AltusCilliers/Design-E-314/Design_E_314_ArcadeGame/Core/Src/main.c

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

/* Includes ------------------------------------------------------------------*/
#include "main.h"

ADC_HandleTypeDef hadc1;

I2C_HandleTypeDef hi2c1;

UART_HandleTypeDef huart2;

void SystemClock_Config(void);
static void MX_GPIO_Init(void);
static void MX_USART2_UART_Init(void);
static void MX_ADC1_Init(void);
static void MX_I2C1_Init(void);
/* USER CODE BEGIN 0 */

uint8_t i2cData[10];
uint8_t i2cMazeData[10];
int16_t ax;
int16_t ay;
int16_t az;
HAL_StatusTypeDef result;

volatile int8_t middle_pressed;
volatile int8_t left_pressed;
volatile int8_t up_pressed;
volatile int8_t down_pressed;
extern int8_t startgame;
int8_t chooseMaze=1;
int8_t startgame = -1;
int8_t xPrev;
int8_t yPrev;
int8_t corner_state=0;
int8_t tennisgameflag=0;
int8_t mazegameflag=0;
extern uint8_t mazemenuflag;
/* USER CODE END 0 */

/**
  * @brief  The application entry point.
  * @retval int
  */
int main(void)
{
  /* MCU Configuration--------------------------------------------------------*/

  /* Reset of all peripherals, Initializes the Flash interface and the Systick. */
  HAL_Init();

  /* Configure the system clock */
  SystemClock_Config();

  /* Initialize all configured peripherals */
  MX_GPIO_Init();
  MX_USART2_UART_Init();
  MX_ADC1_Init();
  MX_I2C1_Init();
  /* USER CODE BEGIN 2 */
	initialize_matrix();

	calibration_sequence();


	int8_t waitScreen=0;
	int8_t game_choose=0;

	game_choose = 3;


	i2cData[0]= 0x20;//set address to CTRL_REG_1
	i2cData[1]= 0x47; //setup REG 1
	//i2cData[1]= 0x57; //setup REG 1
	HAL_I2C_Master_Transmit(&hi2c1, 0x32, i2cData, 2, 10); //transmit

	i2cData[0]= 0x23;//set address to CTRL_REG_4
	i2cData[1]= 0x0;//setup REG 4
	HAL_I2C_Master_Transmit(&hi2c1, 0x32, i2cData, 2, 10);//transmit
//result=HAL_I2C_Master_Transmit(&hi2c1, 0x32, i2cData, 4, 10);


  /* USER CODE END 2 */

  /* Infinite loop */
  /* USER CODE BEGIN WHILE */

	while (1)
	{

//			i2cMazeData[0]=0xA8; //set address to 0xA8 (X_Low address) + auto increment
//			HAL_I2C_Master_Transmit(&hi2c1,0x32,i2cMazeData,1,1);
//			HAL_I2C_Master_Receive(&hi2c1,0x32,i2cMazeData,6,1);
//
//			ax = *((int16_t*)i2cMazeData);
//			ay = *((int16_t*)(i2cMazeData+2));

			//			ax = i2cMazeData[0] + i2cMazeData[1];
			//			ay = i2cMazeData[2] + i2cMazeData[3];
//			ax = *((int8_t*)i2cMazeData) + (*((int8_t*)(i2cMazeData+1))<<8);
//			ay = *((int8_t*)(i2cMazeData+2))+(*((int8_t*)(i2cMazeData+3))<<8);


		 if((middle_pressed==1)&&(mazemenuflag==0))
			  	{
			  		if(waitScreen==1)
			  		{
			  			game_choose = 2; //select tennis game
			  			waitScreen=0;
			  		}else if (waitScreen==0)
			  		{
			  			game_choose = 3; //go back to menu
			  		}
			  		middle_pressed=0;

			  	}

			  	if (left_pressed==1) {

			  		if(waitScreen==1) {
			  			game_choose = 1; //select maze game
			  			mazemenuflag=1;
			  			waitScreen=0;
			  		}
			  		if(game_choose==3 ){
			  			left_pressed=0;
			  		}
			  	}

			  	if(game_choose==1)//maze game
			  	{
			  		maze_game();
			  	}else if(game_choose==2)//tennis game
			  	{
			  		tennis_game();
			  	}else if(game_choose==3)//menu
			  	{
			  		if(waitScreen==0)
			  		{
			  			maze_gameStop();
			  			tennis_gameStop();
			  			waitScreen=1;
			  			wait_screen();
			  		}
			  	}



    /* USER CODE END WHILE */

    /* USER CODE BEGIN 3 */
	}
  /* USER CODE END 3 */
}

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
