AltusCilliers/Design-E-314/Design_E_314_ArcadeGame/Core/Inc/main.h

#define B1_Pin GPIO_PIN_13
#define B1_GPIO_Port GPIOC
#define B1_EXTI_IRQn EXTI15_10_IRQn
#define S5_Pin GPIO_PIN_0
#define S5_GPIO_Port GPIOC
#define S2_Pin GPIO_PIN_1
#define S2_GPIO_Port GPIOC
#define S4_Pin GPIO_PIN_1
#define S4_GPIO_Port GPIOA
#define USART_TX_Pin GPIO_PIN_2
#define USART_TX_GPIO_Port GPIOA
#define USART_RX_Pin GPIO_PIN_3
#define USART_RX_GPIO_Port GPIOA
#define S3_Pin GPIO_PIN_4
#define S3_GPIO_Port GPIOA
#define DEBUG1_Pin GPIO_PIN_5
#define DEBUG1_GPIO_Port GPIOA
#define COL4_Pin GPIO_PIN_6
#define COL4_GPIO_Port GPIOA
#define COL5_Pin GPIO_PIN_7
#define COL5_GPIO_Port GPIOA
#define COL7_Pin GPIO_PIN_4
#define COL7_GPIO_Port GPIOC
#define ROW2_Pin GPIO_PIN_5
#define ROW2_GPIO_Port GPIOC
#define S1_Pin GPIO_PIN_0
#define S1_GPIO_Port GPIOB
#define COL0_Pin GPIO_PIN_1
#define COL0_GPIO_Port GPIOB
#define ROW7_Pin GPIO_PIN_2
#define ROW7_GPIO_Port GPIOB
#define ROW6_Pin GPIO_PIN_11
#define ROW6_GPIO_Port GPIOB
#define ROW5_Pin GPIO_PIN_12
#define ROW5_GPIO_Port GPIOB
#define COL3_Pin GPIO_PIN_13
#define COL3_GPIO_Port GPIOB
#define COL2_Pin GPIO_PIN_14
#define COL2_GPIO_Port GPIOB
#define COL1_Pin GPIO_PIN_15
#define COL1_GPIO_Port GPIOB
#define ROW1_Pin GPIO_PIN_6
#define ROW1_GPIO_Port GPIOC
#define DEBUG2_Pin GPIO_PIN_7
#define DEBUG2_GPIO_Port GPIOC
#define ROW0_Pin GPIO_PIN_8
#define ROW0_GPIO_Port GPIOC
#define DEBUG3_Pin GPIO_PIN_9
#define DEBUG3_GPIO_Port GPIOA
#define COL6_Pin GPIO_PIN_10
#define COL6_GPIO_Port GPIOA
#define ROW4_Pin GPIO_PIN_11
#define ROW4_GPIO_Port GPIOA
#define ROW3_Pin GPIO_PIN_12
#define ROW3_GPIO_Port GPIOA
#define TMS_Pin GPIO_PIN_13
#define TMS_GPIO_Port GPIOA
#define TCK_Pin GPIO_PIN_14
#define TCK_GPIO_Port GPIOA
#define SWO_Pin GPIO_PIN_3
#define SWO_GPIO_Port GPIOB
#define DEBUG4_Pin GPIO_PIN_5
#define DEBUG4_GPIO_Port GPIOB
