AltusCilliers/Design-E-314/Design_E_314_ArcadeGame/Core/Inc/calibration.h

/*
 * calibration.h
 *
 *  Created on: Mar 24, 2021
 *      Author: Altus
 */

#ifndef INC_CALIBRATION_H_
#define INC_CALIBRATION_H_

#include "main.h"
#include "stm32f1xx_it.h"
#include "matrixDisplay.h"

void calibration_sequence();
void wait_screen();


#endif /* INC_CALIBRATION_H_ */
