AltusCilliers/Design-E-314/Design_E_314_ArcadeGame/Core/Inc/demo2game.h

/*
 * demo2game.h
 *
 *  Created on: Apr 15, 2021
 *      Author: Altus
 */

#ifndef INC_DEMO2GAME_H_
#define INC_DEMO2GAME_H_

#include "main.h"
#include "matrixDisplay.h"

void start_game();

#endif /* INC_DEMO2GAME_H_ */
